adesandr/CG_Scale_OlkalBreakout/README.md

# CG_Scale
All files you need to build a F3x Balance CG
