adesandr/CG_Scale_OlkalBreakout/Documentation/PictureBalance2.pdf

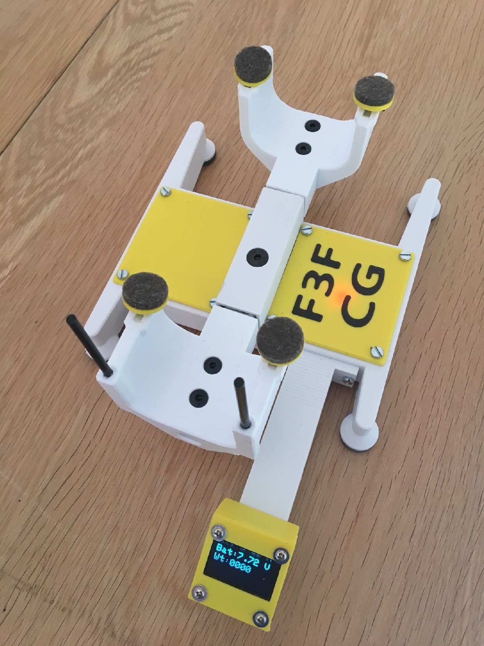
[picture p18: page 1]
