adesandr/CG_Scale_OlkalBreakout/Documentation/PictureBalance.pdf

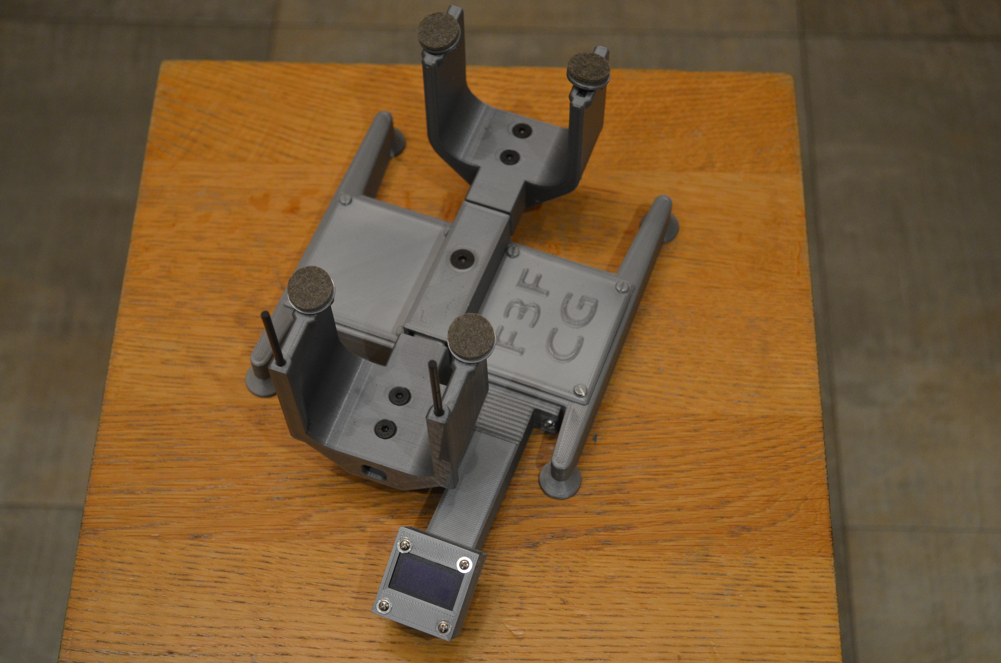
[picture p19: page 1]
