adesandr/CG_Scale_OlkalBreakout/Documentation/Circuit_CG_Scale_I2C.pdf

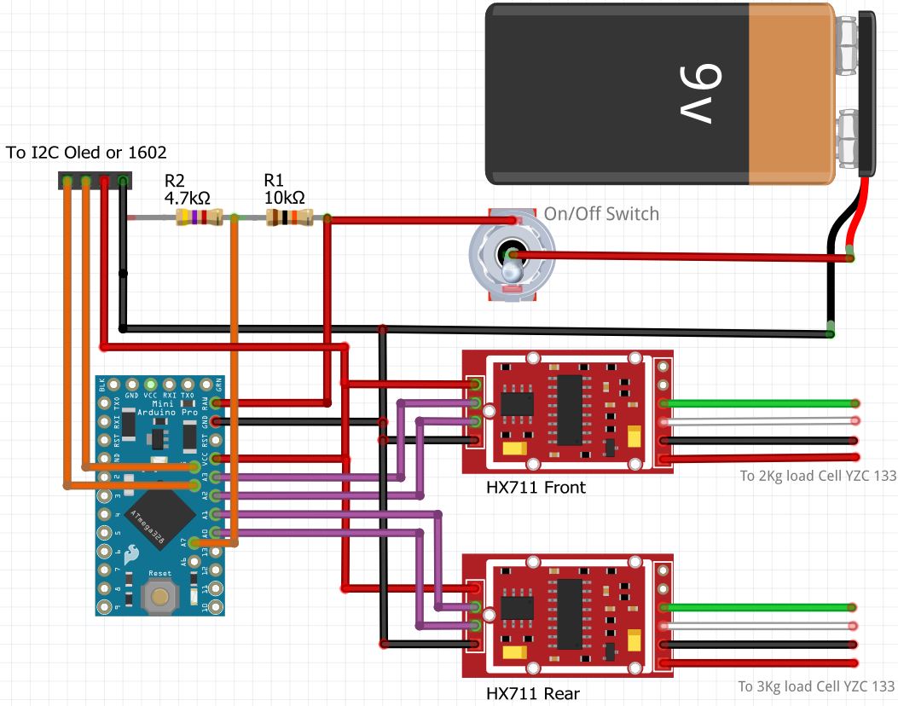
[picture p20: page 1]
