adesandr/CG_Scale_OlkalBreakout/STL print files/LCD version/LCD_case_bot modifié avec plat de maintien et écran.stl

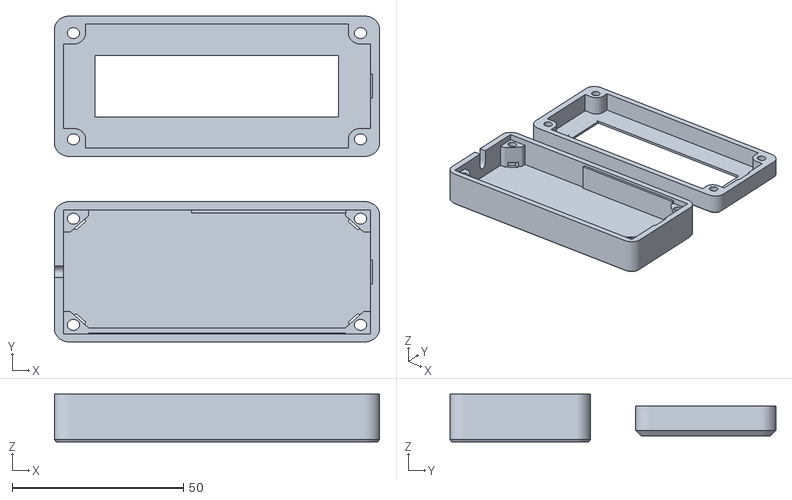
[picture p24: CAD file, 2018-01-22]
STL print files/LCD version/LCD_case_bot modifié avec plat de maintien et écran.stl
95.0 x 95.2 x 14.0
