adesandr/CG_Scale_OlkalBreakout/STL print files/LCD version/LCD_case_bot modifie avec plat de maintien.stl

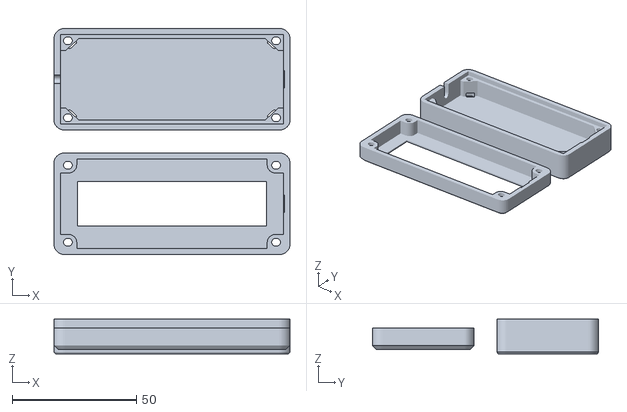
[picture p25: CAD file, 2018-01-22]
STL print files/LCD version/LCD_case_bot modifie avec plat de maintien.stl
95.0 x 91.1 x 14.0
