adesandr/CG_Scale_OlkalBreakout/STL print files/F3F version/Bras Balance.stl

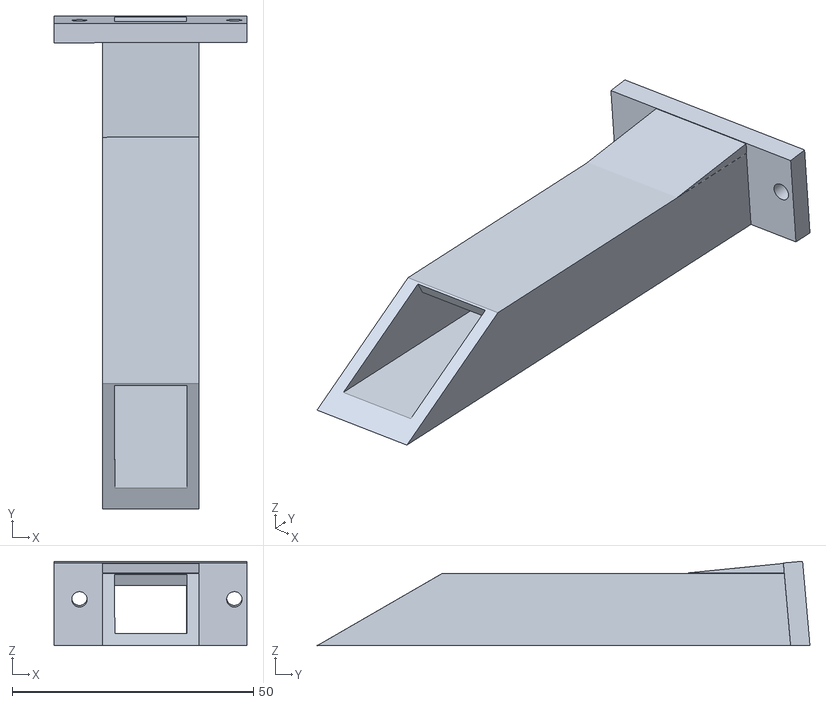
[picture p26: CAD file, 2018-01-22]
STL print files/F3F version/Bras Balance.stl
40.0 x 102.3 x 17.5
