adesandr/CG_Scale_OlkalBreakout/STL print files/F5J version/CG_scale_rear_support_f5j-version.stl

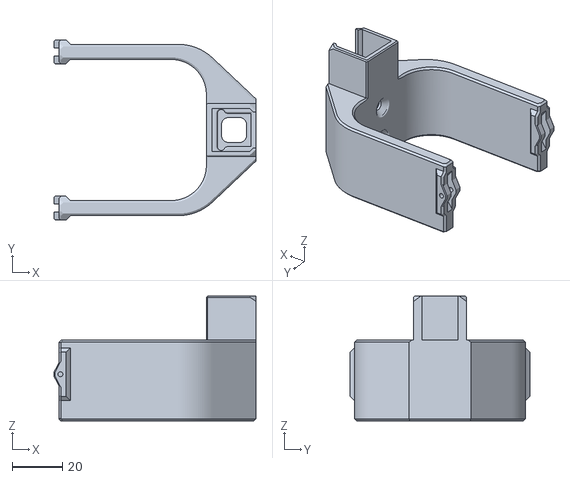
[picture p27: CAD file, 2018-01-21]
STL print files/F5J version/CG_scale_rear_support_f5j-version.stl
80.2 x 71.4 x 49.5
