adesandr/CG_Scale_OlkalBreakout/STL print files/Generics files/Base modifiee+ecrou bras encastre.stl

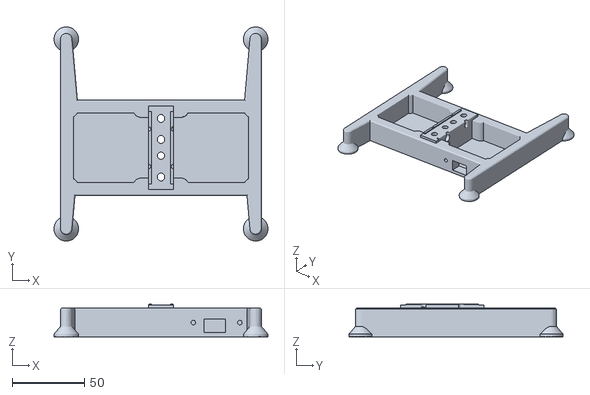
[picture p28: CAD file, 2018-01-22]
STL print files/Generics files/Base modifiee+ecrou bras encastre.stl
147.9 x 148.0 x 22.8
