adesandr/CG_Scale_OlkalBreakout/STL print files/XL Version/Bras arriere arrondis.stl

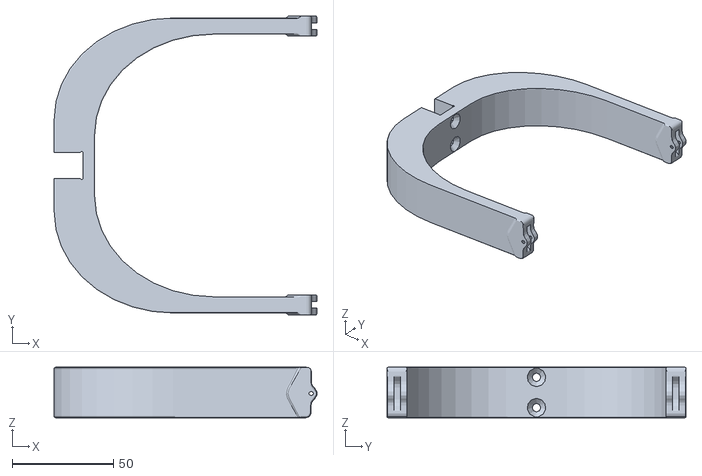
[picture p29: CAD file, 2022-05-15]
STL print files/XL Version/Bras arriere arrondis.stl
130.0 x 148.0 x 25.0
