adesandr/CG_Scale_OlkalBreakout/STL print files/F3F version/CG_scale_framecover_f3f.stl

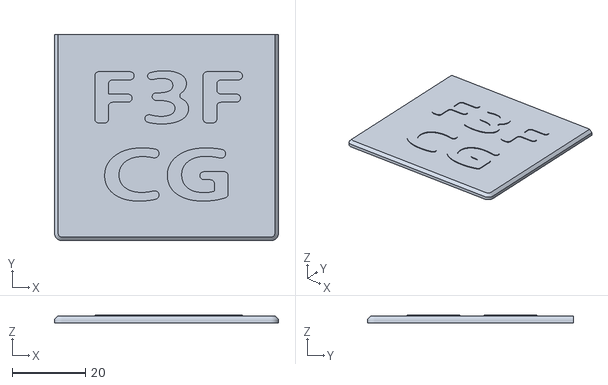
[picture p30: CAD file, 2018-01-21]
STL print files/F3F version/CG_scale_framecover_f3f.stl
61.0 x 56.2 x 2.25
