adesandr/CG_Scale_OlkalBreakout/STL print files/F5J version/CG_scale_front_support_f5j-version.stl

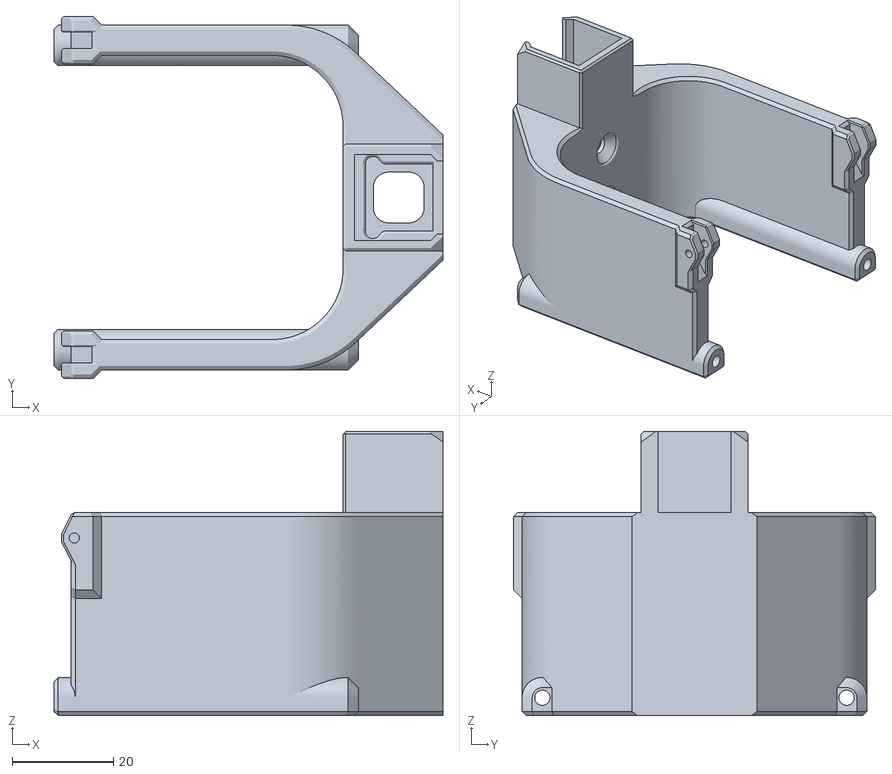
[picture p31: CAD file, 2018-01-21]
STL print files/F5J version/CG_scale_front_support_f5j-version.stl
76.7 x 71.4 x 56.0
