adesandr/CG_Scale_OlkalBreakout/STL print files/Generics files/CG_scale_framecover.stl

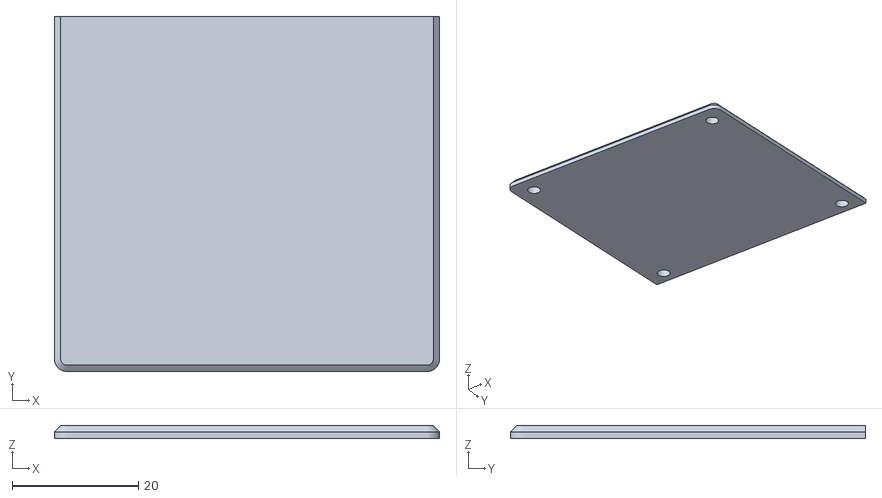
[picture p32: CAD file, 2018-01-21]
STL print files/Generics files/CG_scale_framecover.stl
61.0 x 56.2 x 2.00
