adesandr/CG_Scale_OlkalBreakout/STL print files/XL Version/Bras avant arrondis.stl

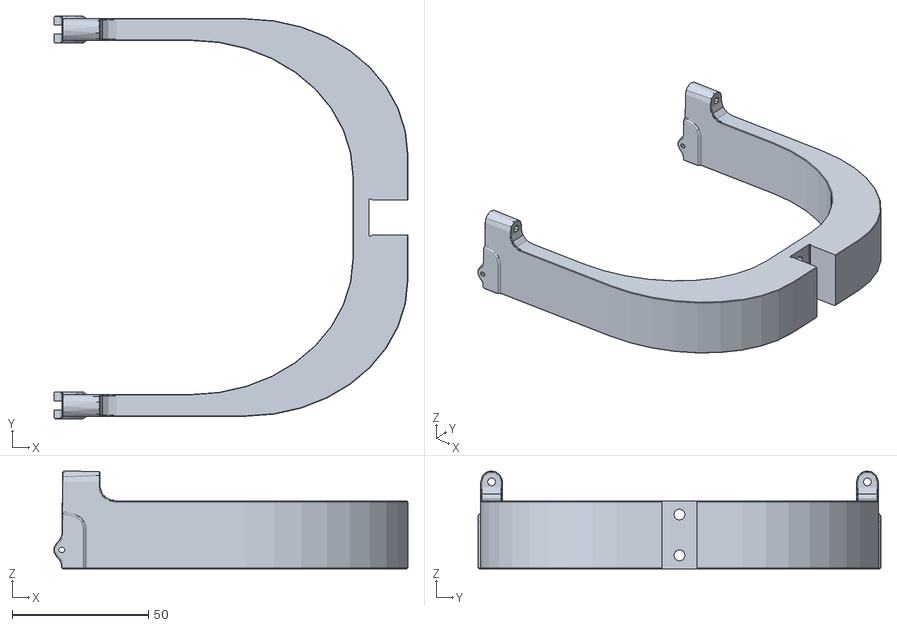
[picture p33: CAD file, 2022-05-15]
STL print files/XL Version/Bras avant arrondis.stl
130.0 x 148.0 x 36.0
