adesandr/CG_Scale_OlkalBreakout/STL print files/Generics files/CG_scale_rear_support.stl

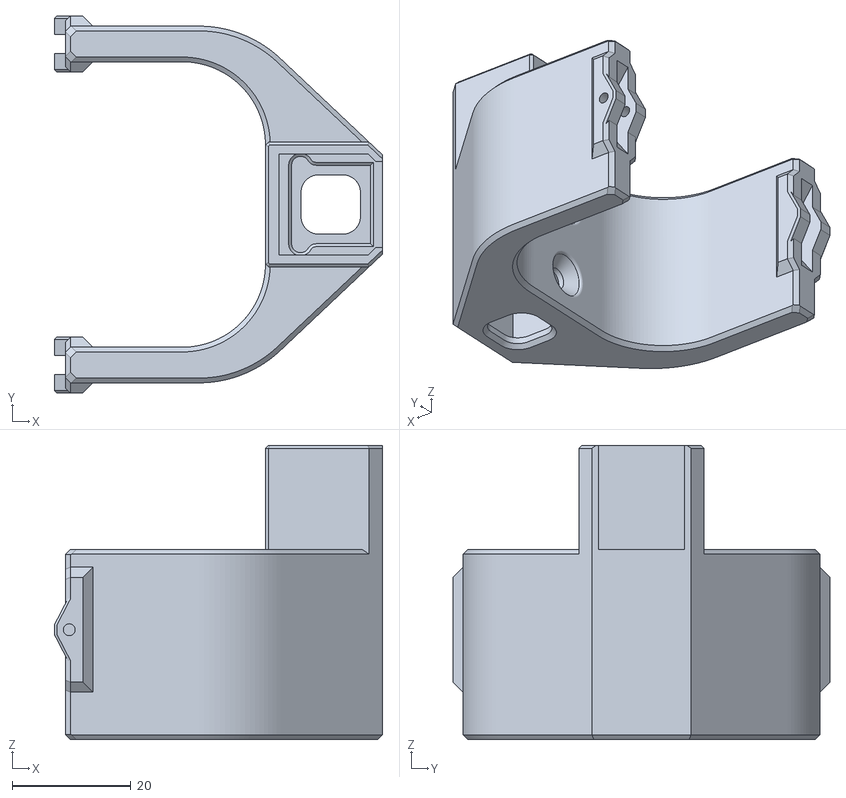
[picture p34: CAD file, 2018-01-21]
STL print files/Generics files/CG_scale_rear_support.stl
55.2 x 63.4 x 49.5
