adesandr/CG_Scale_OlkalBreakout/STL print files/LCD version/LCD_case_bot.stl

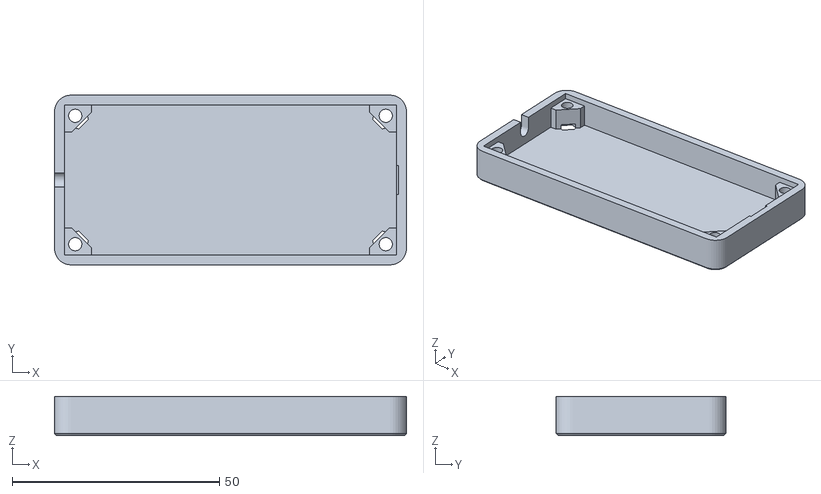
[picture p35: CAD file, 2018-01-21]
STL print files/LCD version/LCD_case_bot.stl
85.0 x 41.0 x 9.50
