adesandr/CG_Scale_OlkalBreakout/STL print files/XL Version/Bras Avant XL 220x290.stl

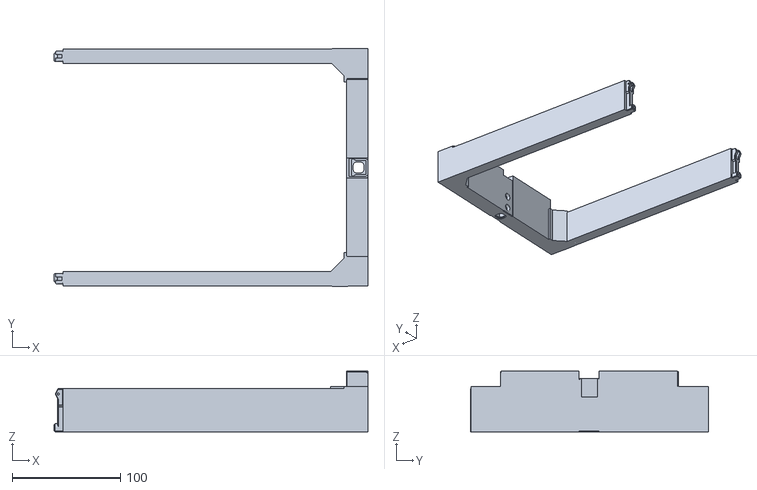
[picture p36: CAD file, 2022-01-09]
STL print files/XL Version/Bras Avant XL 220x290.stl
290.6 x 220.0 x 56.0
