adesandr/CG_Scale_OlkalBreakout/STL print files/Generics files/CG_scale_loadcell_cover.stl

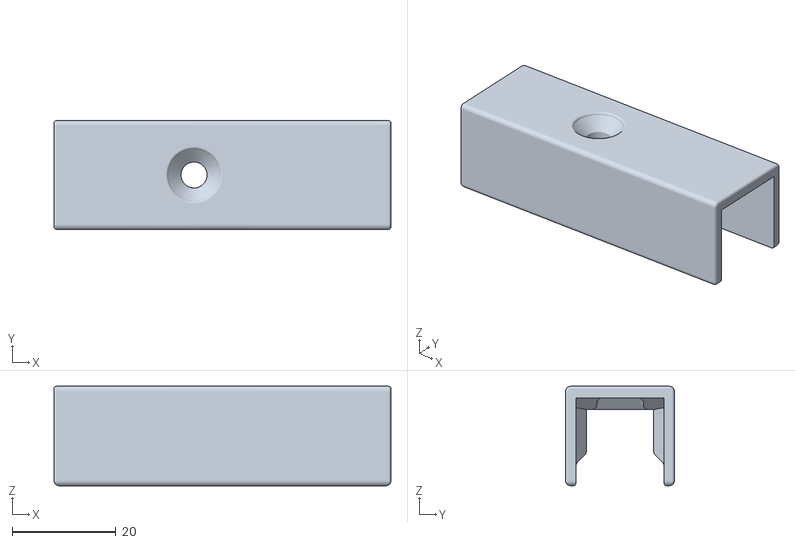
[picture p37: CAD file, 2018-01-21]
STL print files/Generics files/CG_scale_loadcell_cover.stl
65.0 x 21.0 x 19.2
