adesandr/CG_Scale_OlkalBreakout/STL print files/LCD version/LCD_case_top.stl

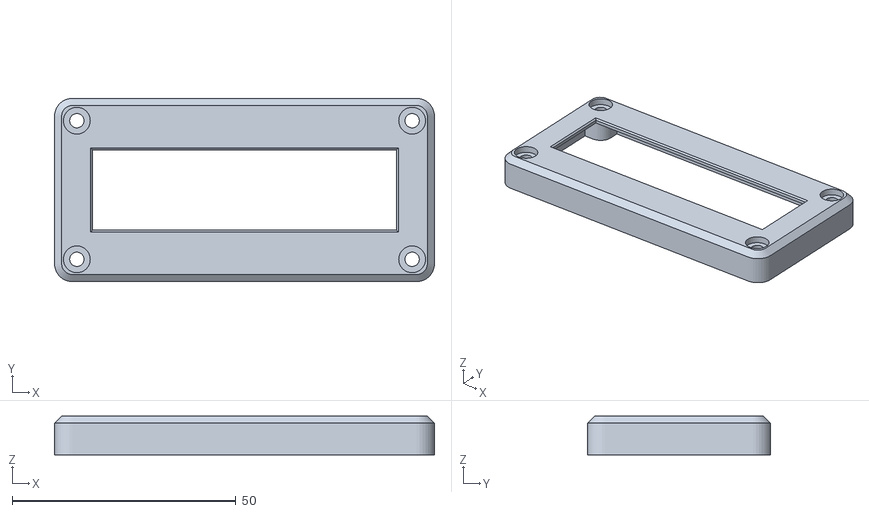
[picture p38: CAD file, 2018-01-21]
STL print files/LCD version/LCD_case_top.stl
85.0 x 41.0 x 8.70
