adesandr/CG_Scale_OlkalBreakout/STL print files/XL Version/Bras Arriere XL 220x290.stl

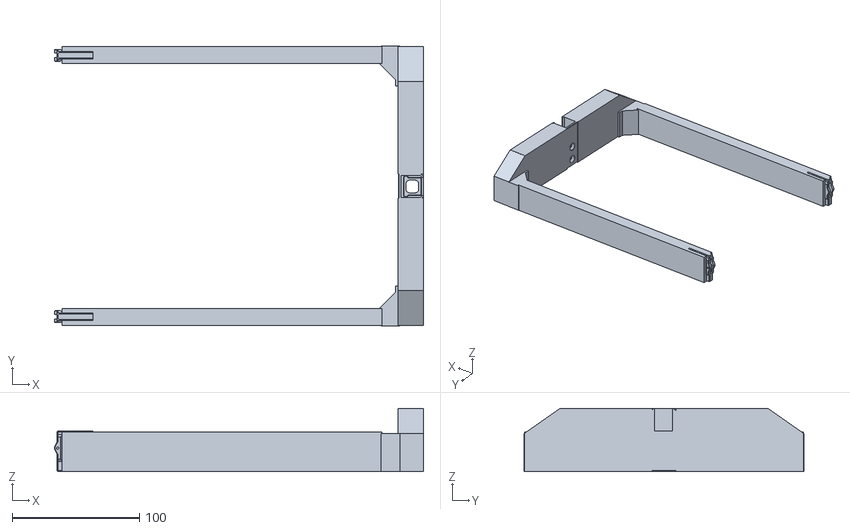
[picture p39: CAD file, 2022-01-09]
STL print files/XL Version/Bras Arriere XL 220x290.stl
290.0 x 220.0 x 49.6
