adesandr/CG_Scale_OlkalBreakout/STL print files/Generics files/CG_scale_front_support.stl

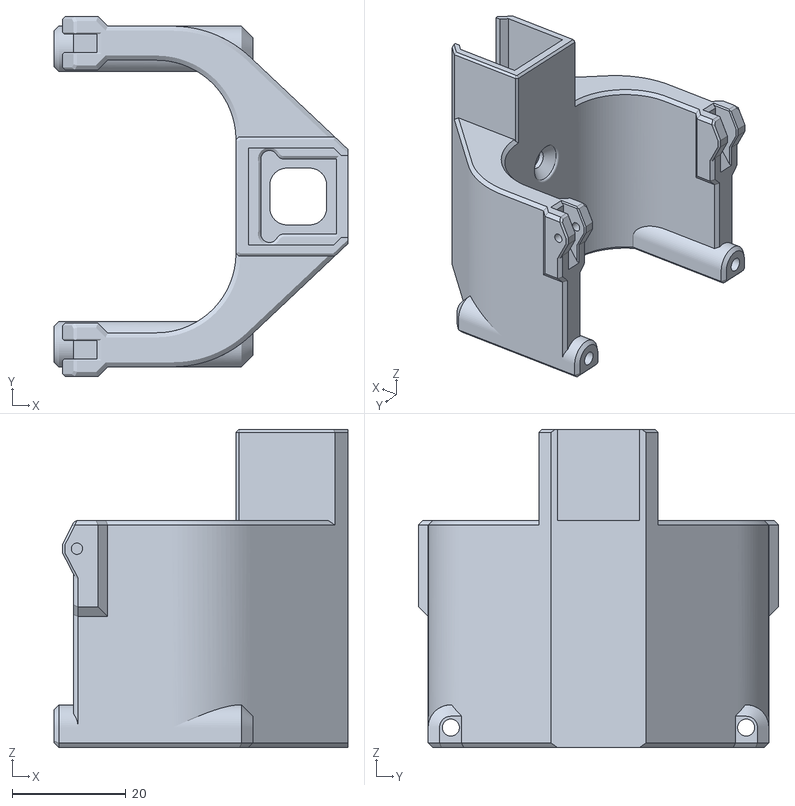
[picture p40: CAD file, 2018-01-21]
STL print files/Generics files/CG_scale_front_support.stl
51.7 x 63.4 x 56.0
