adesandr/CG_Scale_OlkalBreakout/STL print files/Generics files/CG_scale_wing_pad.stl

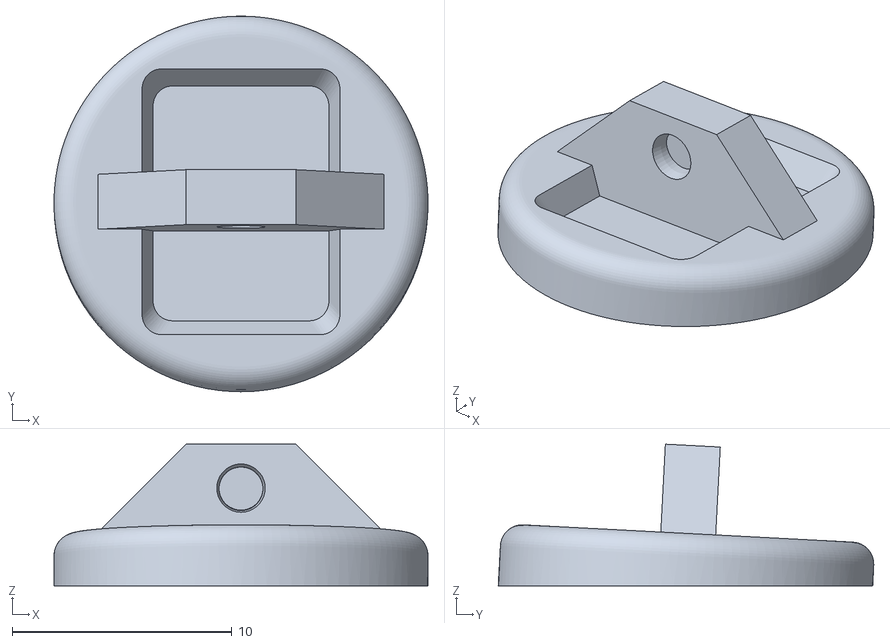
[picture p41: CAD file, 2018-01-21]
STL print files/Generics files/CG_scale_wing_pad.stl
17.0 x 17.1 x 6.44
