adesandr/CG_Scale_OlkalBreakout/(list of files, cad)

Other CAD files:
STL print files/Generics files/CG_scale_frame.stl
