adesandr/CG_Scale_OlkalBreakout/(threads)

Thread 1 (2024-07-16):

I suggest to modify arms design to easily swtch them without having to change the code

RenaudPerr, 2024-07-16:
Hello
I have sent you a mail with following content

Bonjour Alain
Félicitation d'abord pour votre description très détaillée de la construction de la version évoluée de la balance de d’Olav Kallhovd dans le document InstructionsMontageBalanceCG_SCALE.pdf.
Avec la BOM, il facilite grandement la construction et évite des erreurs dans le choix des HX711.
Je viens de commander 2 HX711 Purple Board (High precision) chez TZT sur Aliexpress qui a les "gros" condensateurs apparemment. => https://fr.aliexpress.com/item/1005006969976325.html
Donc je suis en train de la construire et je bloque sur un point.
Je compte imprimer les 3 supports F5J, arrondis et XL et changer ces bras en fonction du modèle à centrer.
C'est pratique il y a juste à dévisser/revisser 4 vis, refaire une calibration (à minima une tare car les poids des supports sont différents) et le tour est joué.
Mais malheureusement je constate que les WingPegDist et LEstopperDist sont différents entre ces 3 supports et qu'il faudrait donc en plus modifier le soft à chaque changement de bras.
C'est dommage car à mon sens il aurait été possible de garder les mêmes valeurs de WingPegDist et LEstopperDist en modifiant légèrement de design de 3 des 6 pièces (cf les ronds rouges ci-dessous)
- Pièces bleue ciel et verte, simplement décaler les 2 trous de vis vers l'arrière
- Pièce orange, déplacer les supports de plots vers l'arrière.
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
J'en suis arrivé à la conclusion que ces supports ont été modélisés par des personnes différentes sans concertation, ce qui est tout à fait compréhensible.
Partagez-vous mon analyse ou y-a-t-il un point qui m'a échappé?
Dans une démarche d'amélioration de la qualité, je souhaiterais donc adapter les 3 supports concernés avec Fusion 360.
Donc auriez-vous les fichiers natifs (et pas .STL) de ces pièces SVP?
NB: On peut importer un STL dans Fusion mais il faut faire une transformation assez lourde pour le transformer en Corps modifiable.
Une fois la modif faite, je suis prêt à partager ces nouveaux fichiers avec vous.
Bien cordialement
Renaud Perriguey

PS: je viens de voir que c'est Dam qui a ajouté les fichiers "Arrondis"
