adesandr/CG_Scale_OlkalBreakout/(list of files, drawings)

Other design files:
Fritzing & Gerber/CG_Balance_V1.4.fzz
