adesandr/CG_Scale_OlkalBreakout/(commit log)

2018-03-26 Arduino download adds & USB-TTL <-> Arduino.
2018-03-26 Arduino download adds & USB-TTL <-> Arduino
2018-05-21 Add files via upload
    Calibration both HX711, front and rear.
    Using the serial monitor, enter 'F' for front and 'R' for rear to choose the ADC.
    After that, type 'l' to decrease the cell factor of -1, and 'L' for -10.
    type 'h' to increase by +1, and 'H' by +10
2018-08-05 Add files via upload
    Ajout chapitre sur les principes de fonctionnement des jauges de contrainte et du HX711
2018-08-05 Add files via upload
    Ajout première version de la documentation en anglais.
2022-01-09 Documentation update
    [Base modifiee+ecrou bras encastre.stl, Bras Arriere XL 220x290.stl, Bras Avant XL 220x290.stl, Bras Balance.stl, CG_scale_frame.stl, CG_scale_framecover.stl, CG_scale_framecover_f3f.stl, CG_scale_front_support.stl]
2022-05-15 Add files via upload
    Added by Dams, thanks to him.
    [Bras arriere arrondis.stl, Bras avant arrondis.stl]
2026-08-21 V2 OLED I2C Logo Correction
